mteter-upenn/PCB_PiGateway/board_design_map.txt

1.x: Pololu PS, DIP switches, full size, male term blocks
2.x: Recom PS, DIP switches, full size, male and female term blocks
3.x: Recom PS, DIP switches, reduc size, term block and barrel jack
