mteter-upenn/PCB_PiGateway/Modbus_shield_purchase_list.xlsx

Sheet: teensy
 |  | Approx. |  | Approx. | Req for 4.0
Part | Link | Cost Per | # to Order | Order Cost |  | New | Total # Desired | # in Stock | # Being Shipped | Alternatives
PCB - 3V3 - 42 x 49 mm | OSHPark (https://oshpark.com/) | $5.32 | 0 | $0.00 | 0 | 0 | 0 | 0 | 0
PCB -3V3 - 32.8 x 86.9 mm | OSHPark (https://oshpark.com/) | $7.35 | 0 | $0.00 | 0 | 0 | 0 | 0 | 0
PCB - 3V3 - 49.5 x 58.5 mm | OSHPark (https://oshpark.com/) | $7.47 | 3 | $22.42 | 3 | 3 | 3 | 0 | 0
Teensy 3.2 | PJRC (https://www.pjrc.com/store/teensy32.html) | $19.80 | 3 | $59.40 | 3 | 3 | 3 | 0 | 0 | SparkFun (https://www.sparkfun.com/products/13736) | $19.95
Teensy SD Card Adapter | PJRC (https://www.pjrc.com/store/wiz820_sd_adaptor.html) | $6.00 | 3 | $18.00 | 3 | 3 | 3 | 0 | 0
Wiz820io | Mouser (http://www.mouser.com/ProductDetail/WIZnet/WIZ820io/?qs=b%252bXOOdUOuvZr7ySTpTRyJw%3D%3D) | $20.79 | 3 | $62.37 | 3 | 3 | 3 | 0 | 0
32.768 kHz Crystal 5ppm | Digikey (http://www.digikey.com/product-search/en?keywords=300-8763-ND) | $0.60 | 3 | $1.80 | 3 | 3 | 3 | 0 | 0
CR2032 Battery | Digikey (http://www.digikey.com/product-detail/en/CR2032/P189-ND/31939) | $0.28 | 3 | $0.84 | 3 | 3 | 3 | 0 | 0
Vert CR2032 Battery Holder | Digikey (http://www.digikey.com/product-detail/en/BK-5058/BK-5058-ND/2194769) | $0.88 | 3 | $2.64 | 3 | 3 | 3 | 0 | 0
1x4 female header | Digikey (http://www.digikey.com/product-detail/en/PPPC041LFBN-RC/S7037-ND/810176) | $0.62 | 0 | $0.00 | 0 | 0 | 6 | 6 | 0
1x5 female header | Digikey (http://www.digikey.com/product-detail/en/PPPC051LFBN-RC/S7038-ND/810177) | $0.65 | 3 | $1.95 | 3 | 3 | 3 | 0 | 0
1x6 female header | Digikey (http://www.digikey.com/product-detail/en/PPPC061LFBN-RC/S7039-ND/810178) | $0.70 | 6 | $4.20 | 6 | 6 | 6 | 0 | 0
1x14 female header | Digikey (http://www.digikey.com/product-detail/en/PPPC141LFBN-RC/S7047-ND/810186) | $0.98 | 12 | $11.76 | 12 | 12 | 12 | 0 | 0
1x40 male header | Digikey (http://www.digikey.com/product-detail/en/PRPC040SAAN-RC/S1011EC-40-ND/2775214) | $0.74 | 0 | $0.00 | 1 | 0 | 21.875 | 21.875 | 0
1x40 male dbl long header | Digikey (http://www.digikey.com/product-search/en?vendor=0&keywords=PRPC040SACN-RC) | $0.99 | 1 | $0.99 | 3 | 1 | 3.175 | 2.175 | 0 |  | 64
120ohm 1206 resistor | Digikey (http://www.digikey.com/product-detail/en/RC1206FR-07120RL/311-120FRCT-ND/731470) | $0.10 | 0 | $0.00 | 0 | 0 | 0 | 0 | 0
270ohm 1206 resistor | Digikey (http://www.digikey.com/product-detail/en/RC1206FR-07270RL/311-270FRCT-ND/731681) | $0.10 | 0 | $0.00 | 0 | 0 | 0 | 0 | 0 | 10
510ohm 1206 resistor | Digikey (http://www.digikey.com/product-detail/en/RC1206JR-07510RL/311-510ERCT-ND/732257) | $0.10 | 0 | $0.00 | 0 | 0 | 0 | 0 | 0 | 10
680ohm 1206 resistor | Digikey (http://www.digikey.com/product-detail/en/RC1206FR-07680RL/311-680FRCT-ND/732011) | $0.10 | 0 | $0.00 | 0 | 0 | 0 | 0 | 0 | 10
1kohm 1206 resistor | Digikey (http://www.digikey.com/product-detail/en/RC1206FR-071KL/311-1.00KFRCT-ND/731334) | $0.10 | 0 | $0.00 | 0 | 0 | 0 | 0 | 0 | 10
10kohm 1206 resistor | Digikey (http://www.digikey.com/product-detail/en/RC1206JR-0710KL/311-10KERCT-ND/732156) | $0.10 | 0 | $0.00 | 0 | 0 | 0 | 0 | 0 | 10
104 1206 capacitor | Digikey (http://www.digikey.com/product-detail/en/C1206C104J5RACTU/399-1250-1-ND/411525) | $0.10 | 0 | $0.00 | 0 | 0 | 0 | 0 | 0
Green 2V 20mA 1206 LED | Digikey (http://www.digikey.com/product-detail/en/LTST-C230KGKT/160-1456-1-ND/386854) | $0.30 | 0 | $0.00 | 0 | 0 | 0 | 0 | 0
Red 2V 20mA 1206 LED | Digikey (http://www.digikey.com/product-detail/en/LTST-C230KRKT/160-1457-1-ND/386856) | $0.30 | 0 | $0.00 | 0 | 0 | 0 | 0 | 0
Orange 2V 20mA 1206 LED | Digikey (http://www.digikey.com/product-detail/en/LTST-C230KFKT/160-2025-1-ND/3711400) | $0.29 | 0 | $0.00 | 0 | 0 | 0 | 0 | 0
120ohm 0603 resistor | Digikey (http://www.digikey.com/product-detail/en/RC0603FR-07120RL/311-120HRCT-ND/729867) | $0.01 | 10 | $0.14 | 3 | 10 | 11 | 1 | 0
180ohm 0603 resistor | Digikey (http://www.digikey.com/product-detail/en/yageo/RC0603FR-07180RL/311-180HRCT-ND/729941) | $0.01 | 10 | $0.14 | 3 | 10 | 10 | 0 | 0
270ohm 0603 resistor | Digikey (http://www.digikey.com/product-detail/en/RC0603FR-07270RL/311-270HRCT-ND/730050) | $0.01 | 10 | $0.14 | 3 | 10 | 11 | 1 | 0
510ohm 0603 resistor | Digikey (http://www.digikey.com/product-detail/en/RC0603FR-07510RL/311-510HRCT-ND/730232) | $0.01 | 10 | $0.14 | 6 | 10 | 10 | 0 | 0
680ohm 0603 resistor | Digikey (http://www.digikey.com/product-detail/en/RC0603FR-07680RL/311-680HRCT-ND/730302) | $0.01 | 15 | $0.15 | 15 | 15 | 20 | 5 | 0
1kohm 0603 resistor | Digikey (http://www.digikey.com/product-detail/en/RC0603FR-071KL/311-1.00KHRCT-ND/729790) | $0.01 | 10 | $0.14 | 12 | 10 | 18 | 8 | 0
5.1kohm 0603 resistor | Digikey (http://www.digikey.com/product-detail/en/yageo/RC0603FR-075K1L/311-5.10KHRCT-ND/730215) | $0.01 | 10 | $0.14 | 3 | 10 | 10 | 0 | 0
10kohm 0603 resistor | Digikey (http://www.digikey.com/product-detail/en/RC0603FR-0710KL/311-10.0KHRCT-ND/729827) | $0.01 | 10 | $0.14 | 6 | 10 | 12 | 2 | 0
33kohm 0603 resistor | Digikey (http://www.digikey.com/product-detail/en/RC0603FR-0733KL/311-33.0KHRCT-ND/730106) | $0.01 | 10 | $0.10 | 3 | 10 | 11 | 1 | 0
104 0603 capacitor | Digikey (http://www.digikey.com/product-detail/en/C0603C104J4RACTU/399-1097-1-ND/411372) | $0.11 | 6 | $0.66 | 6 | 6 | 6 | 0 | 0
273 0603 capacitor | Digikey (http://www.digikey.com/product-detail/en/samsung-electro-mechanics-america-inc/CL10B273KB8NNNC/1276-2025-1-ND/3890111) | $0.11 | 3 | $0.33 | 3 | 3 | 3 | 0 | 0
Green 2V 20mA 0603 LED | Digikey (http://www.digikey.com/product-detail/en/LTST-C191KGKT/160-1446-1-ND/386834) | $0.29 | 3 | $0.87 | 3 | 3 | 3 | 0 | 0
Red 2V 20mA 0603 LED | Digikey (http://www.digikey.com/product-detail/en/LTST-C191KRKT/160-1447-1-ND/386836) | $0.29 | 10 | $2.90 | 9 | 10 | 17 | 7 | 0
Yellow 2V 20mA 0603 LED | Digikey (http://www.digikey.com/product-detail/en/lite-on-inc/LTST-C191KSKT/160-1448-1-ND/386838) | $0.30 | 12 | $3.60 | 12 | 12 | 13 | 1 | 0
Term Block 6Pin .2" 180 header | Digikey (http://www.digikey.com/product-detail/en/1546111-6/A112348-ND/2221132) | $2.42 | 0 | $0.00 | 0 | 0 | 0 | 0 | 0
Term Block 3 Pin .2" 90 header | Digikey (http://www.digikey.com/product-detail/en/796639-3/A114504-ND/1131834) | $0.86 | 6 | $5.16 | 6 | 6 | 6 | 0 | 0
Term Block 3 Pin .2" 270 Plug | Digikey (http://www.digikey.com/product-detail/en/284041-3/A98129-ND/1826991) | $2.73 | 6 | $16.38 | 6 | 6 | 6 | 0 | 0
R-78-E5.0, 500mA voltage regulator | Digikey (http://www.digikey.com/product-detail/en/recom-power/R-78E5.0-0.5/945-1648-5-ND/2834904) | $2.84 | 3 | $8.52 | 3 | 3 | 3 | 0 | 0
Wide DIN case | Digikey (http://www.digikey.com/product-detail/en/DMB-4771/377-1808-ND/2499327) | $5.50 | 3 | $16.50 | 3 | 3 | 3 | 0 | 0
Wide DIN case clear cover | Digikey (http://www.digikey.com/product-search/en?vendor=0&keywords=dmb-4771-cc) | $1.10 | 3 | $3.30 | 3 | 3 | 3 | 0 | 0
Slim DIN case | Digikey (http://www.digikey.com/product-detail/en/DMB-4770/377-1807-ND/2499326) | $4.50 | 0 | $0.00 | 0 | 0 | 0 | 0 | 0
Heatsink 10mm square | Digikey (http://www.digikey.com/product-detail/en/assmann-wsw-components/V2017B/AE10837-ND/3511410) | $0.75 | 6 | $4.50 | 3 | 6 | 6 | 0 | 0
16GB Micro SD Card | Amazon (https://www.amazon.com/SanDisk-Ultra-Micro-Adapter-SDSQUNC-016G-GN6MA/dp/B010Q57SEE) | $9.70 | 3 | $29.10 | 3 | 3 | 3 | 0 | 0
Max485esa+ transceiver | Digikey (http://www.digikey.com/product-detail/en/MAX485ESA%2B/MAX485ESA%2B-ND/1495323) | $2.66 | 3 | $7.98 | 3 | 3 | 3 | 0 | 0
2N7002 transistor sot-23-3 | Digikey (http://www.digikey.com/product-detail/en/2N7002LT1G/2N7002LT1GOSCT-ND/917791) | $0.14 | 10 | $1.40 | 9 | 10 | 19 | 9 | 0
NC7SB3157P6X SPDT | Digikey (http://www.digikey.com/product-detail/en/fairchild-semiconductor/NC7SB3157P6X/NC7SB3157P6XCT-ND/1305384) | $0.39 | 3 | $1.17 | 3 | 3 | 3 | 0 | 0
FSA3357K8X SP3T | Digikey (http://www.digikey.com/product-detail/en/fairchild-semiconductor/FSA3357K8X/FSA3357K8XCT-ND/821001) | $0.96 | 3 | $2.88 | 3 | 3 | 3 | 0 | 0
MAX4525EUB+ DPDT | Digikey (http://www.digikey.com/product-detail/en/maxim-integrated/MAX4525EUB-/MAX4525EUB--ND/1780258) | $2.56 | 3 | $7.68 | 3 | 3 | 3 | 0 | 0
MB85RS256BPNF FRAM 32kB Memory | Digikey (http://www.digikey.com/product-detail/en/fujitsu-electronics-america-inc/MB85RS256BPNF-G-JNERE1/865-1251-1-ND/4022686) | $3.50 | 3 | $10.50 | 3 | 3 | 3 | 0 | 0
SPDT dip switch | Digikey (http://www.digikey.com/product-detail/en/CJS-1200TB/563-1022-1-ND/948402) | $0.86 | 0 | $0.00 | 0 | 0 | 0 | 0 | 0
SPDT dip switch neutral setting | Digikey (http://www.digikey.com/product-detail/en/CJS-1201TB/563-1024-1-ND/948406) | $1.11 | 0 | $0.00 | 0 | 0 | 0 | 0 | 0
DPDT dip switch | Digikey (http://www.digikey.com/product-detail/en/CAS-220TB/CAS220GCT-ND/341727) | $2.04 | 0 | $0.00 | 0 | 0 | 0 | 0 | 0
One offs:
Display Board | Amazon (http://www.amazon.com/dp/B019K6CRVY/ref=sxr_pa_click_within_right_aps_sr_pg1_2?psc=1) | $72.90 | 0 | $0.00 |  | 0 | 0 | 0 | 0
Raspberry Pi 2 | Amazon (http://www.amazon.com/Raspberry-Pi-Model-Project-Board/dp/B00T2U7R7I?s=pc) | $36.05 | 0 | $0.00 |  | 0 | 0 | 0 | 0
5V 2.5 A Power Supply | Amazon (http://www.amazon.com/CanaKit-Raspberry-Supply-Adapter-Charger/dp/B00MARDJZ4) | $9.99 | 0 | $0.00 |  | 0 | 0 | 0 | 0
Anti Static Mat | Amazon (https://smile.amazon.com/StarTech-com-24x27-5-Inch-Desktop-Anti-Static-M3013/dp/B00009XT3H) | $15.83 | 1 | $15.83 |  | 1 | 1 | 0 | 0
Anti Static Wrist Band | Amazon (https://smile.amazon.com/Rosewill-Anti-Static-Components-RTK-002-Yellow/dp/B004N8ZQKY) | $5.99 | 1 | $5.99 |  | 1 | 1 | 0 | 0
Plug with Ground | Amazon (https://smile.amazon.com/Leviton-5266-C-Industrial-Grounding-Black-White/dp/B001VXU4TC) | $7.49 | 1 | $7.49 |  | 1 | 1 | 0 | 0
No Clean Flux | Amazon (https://www.amazon.com/gp/product/B00425FUW2?ref%5F=sr%5F1%5F4&pldnSite=1) | $12.29 | 1 | $12.29 |  | 1 | 1 | 0 | 0
Soldering Paste | Amazon (https://smile.amazon.com/Clean-Leaded-Solder-Paste-Grams/dp/B017RSZFQQ) | $9.95 | 1 | $9.95 |  | 1 | 1 | 0 | 0
Kim dry wipes | Amazon (https://www.amazon.com/gp/product/B00RORBXA8?ref%5F=sr%5F1%5F1&pldnSite=1) | $5.30 | 1 | $5.30 |  | 1 | 1 | 0 | 0
Tweezers | Sparkfun (https://www.sparkfun.com/products/10602) | $3.95 | 0 | $0.00 |  | 0 | 0 | 0 | 0
USB A to micro | Amazon (http://www.amazon.com/dp/B00NH13LSM/ref=twister_B00DGRUY3M?_encoding=UTF8&psc=1) | $4.69 | 0 | $0.00 |  | 0 | 0 | 0 | 0
USB A to Micro | Adafruit (https://www.adafruit.com/products/592) | $2.95 | 0 | $0.00 |  | 0 | 0 | 0 | 0
USB A to micro | Digikey (http://www.digikey.com/product-detail/en/3025010-03/Q853-ND/4341883) | $2.31 | 0 | $0.00 |  | 0 | 0 | 0 | 0
9V 650mA Power Supply | Sparkfun (https://www.sparkfun.com/products/298) | $5.95 | 0 | $0.00 |  | 0 | 0 | 0 | 0
5V 2A (2000mA) switching power supply | Adafruit (https://www.adafruit.com/products/276) | $7.95 | 0 | $0.00 |  | 0 | 0 | 0 | 0
5V 2A Switching Power Supply w/ USB-A Connector | Adafruit (https://www.adafruit.com/products/1994) | $6.95 | 0 | $0.00 |  | 0 | 0 | 0 | 0
5V 550mA Switch PS via USB | Digikey (http://www.digikey.com/product-detail/en/PSM03A-050Q/993-1030-ND/2384456) | $4.25 | 0 | $0.00 |  | 0 | 0 | 0 | 0
Bluetooth Mouse | Amazon (https://www.amazon.com/Microsoft-Sculpt-Comfort-Bluetooth-H3S-00003/dp/B00BZC31WQ?s=pc) | $24.95 | 0 | $0.00 |  | 0 | 0 | 0 | 0
Electric Soldering Iron | Amazon (http://smile.amazon.com/Weller-WES51-Analog-Soldering-Station/dp/B000BRC2XU) | $93.37 | 0 | $0.00 |  | 0 | 0 | 0 | 0
Small soldering tip | Amazon (http://smile.amazon.com/Weller-eto-0-8-PRICE-EACH/dp/B0002BSQRQ) | $6.11 | 0 | $0.00 |  | 0 | 0 | 0 | 0
Small soldering tip | Digikey (http://www.digikey.com/product-detail/en/ETH/ETH-ND/251751) | $4.10 | 0 | $0.00 |  | 0 | 0 | 0 | 0
Head magnifier | Amazon (http://smile.amazon.com/gp/product/B003UCODIA?psc=1&redirect=true&ref_=oh_aui_search_detailpage) | $8.99 | 0 | $0.00 |  | 0 | 0 | 0 | 0
AAA Batteries | Digikey (http://www.digikey.com/product-detail/en/LR03XWA%2FB/P645-ND/2043736) | $0.38 | 0 | $0.00 |  | 0 | 0 | 0 | 0
pcb vise | Amazon (http://smile.amazon.com/gp/product/B000B61D22?psc=1&redirect=true&ref_=oh_aui_search_detailpage) | $26.99 | 0 | $0.00 |  | 0 | 0 | 0 | 0
Total |  |  |  | $367.88
 |  |  |  |  |  |  |  | $25.88
 |  |  |  |  | $103.51 | board cost
Discontinued
Orange 2V 20mA 0603 LED | Digikey (http://www.digikey.com/product-detail/en/LTST-C191KFKT/160-1445-1-ND/386832) | $0.24 | 0 | $0.00 | 0 | 0 | 0 | 0 | 0
MCP1825S33 3V3 Voltage Regulator | Digikey (http://www.digikey.com/product-detail/en/MCP1825S-3302E%2FDB/MCP1825S-3302E%2FDB-ND/1636103) | $0.51 | 0 | $0.00 | 0 | 0 | 0 | 0 | 0
485 shield | Sparkfun (https://www.sparkfun.com/products/12965) | $11.95 | 0 | $0.00 | 0 | 0 | 0 | 0 | 0
2.1mm barrel jack | Pololu (https://www.pololu.com/product/1139) | $0.85 | 0 | $0.00 | 0 | 0 | 2 | 2 | 0
D24V5F5 5V, .5A power regulator | Pololu (https://www.pololu.com/product/2843) | $4.95 | 0 | $0.00 | 0 | 0 | 2 | 2 | 0
CR2032 Battery Holder | Sparkfun (https://www.sparkfun.com/products/783) | $1.50 | 0 | $0.00 | 0 | 0 | 0 | 0 | 0
Heat sink .4 x .4" | Adafruit (https://www.adafruit.com/products/1042) | $1.95 | 0 | $0.00 | 0 | 0 | 3 | 3 | 0
Heat Sink .25 x .25" | Adafruit (https://www.adafruit.com/products/1515) | $4.95 | 0 | $0.00 | 0 | 0 | 0 | 0 | 0
8GB Micro SD Card | Amazon (http://www.amazon.com/SanDisk-MicroSDHC-Standard-Packaging-SDSDQUAN-008G-G4A/dp/B00M55C0VU) | $7.62 | 0 | $0.00 | 0 | 0 | 0 | 0 | 0
32GB Micro SD Card | Amazon (http://www.amazon.com/SanDisk-microSDHC-Standard-Packaging-SDSQUNC-032G-GN6MA/dp/B010Q57T02?s=electronics) | $12.86 | 0 | $0.00 | 0 | 0 | 0 | 0 | 0
D24V5F3, .5A power regulator | Pololu (https://www.pololu.com/product/2842) | $4.95 | 0 | $0.00 | 0 | 0 | 0 | 0 | 0
1x8 female header | Digikey (http://www.digikey.com/product-detail/en/PPPC081LFBN-RC/S7041-ND/810180) | $0.89 | 0 | $0.00 | 0 | 0 | 0 | 0 | 0
100ohm 1206 resistor | Digikey (http://www.digikey.com/product-detail/en/RC1206FR-07100RL/311-100FRCT-ND/731438) | $0.10 | 0 | $0.00 | 0 | 0 | 0 | 0 | 0
220ohm 1206 resistor | Digikey (http://www.digikey.com/product-detail/en/RC1206FR-07220RL/311-220FRCT-ND/731640) | $0.10 | 0 | $0.00 | 0 | 0 | 0 | 0 | 0
Term Block 3 Pin .2" 180 plug | Digikey (http://www.digikey.com/product-detail/en/796634-3/A98224-ND/1827083) | $1.40 | 0 | $0.00 | 0 | 0 | 0 | 0 | 0
 |  |  |  |  |  |  | 1.5
 |  |  |  | 29.4 |  |  | 0.002205882353
 |  |  |  | 8.4 |  |  | 1450.666667
 |  |  |  | 26.22
 |  |  |  | 3.18 |  |  | 0.0032
 |  |  |  | 3.35

Sheet: pi
 |  | Approx. | 6 | Approx. | Req for 1.0 |  | 2.0
Part | Link | Cost Per | # to Order | Order Cost | per brd | total |  |  | New | Total # Desired | # in Stock | # Being Shipped | Alternatives
485/Power PiHat 1.0 | OSHPark (https://oshpark.com/) | $9.40 | 0 | $0.00 | 1 | 6 | 0 | 0 | 0 | 0 | 0 | 0
485/Power PiHat 2.0 | OSHPark (https://oshpark.com/) | $9.40 | 0 | $0.00 | 0 | 0 | 0 | 0 | 0 | 0 | 0 | 0
485/Power PiHat 2.0 Super Swift | OSHPark (https://oshpark.com/) | $18.80 | 0 | $0.00 | 0 | 0 | 1 | 6 | 0 | 0 | 0 | 0
Raspberry Pi 3 Model B | Amazon (https://www.amazon.com/Raspberry-Model-1-2GHz-64-bit-quad-core/dp/B01CD5VC92?s=pc) | $36.99 | 0 | $0.00 | 1 | 6 | 1 | 6 | 0 | 0 | 0 | 0
#4-40 3/16" screw (100 pk) | McMaster-Carr (https://www.mcmaster.com/) | $1.62 | 0 | $0.00 | 0.04 | 1 | 0.04 | 1 | 0 | 0.61 | 0.61 | 0
#4-40 nut (100 pk) | McMaster-Carr (https://www.mcmaster.com/) | $2.36 | 0 | $0.00 | 0.02 | 1 | 0.02 | 1 | 0 | 0.82 | 0.82 | 0
#4-40 7/16" standoff | McMaster-Carr (https://www.mcmaster.com/) | $0.68 | 0 | $0.00 | 4 | 24 | 4 | 24 | 0 | 0 | 0 | 0
M2.5x.45 12mm standoffs | Digikey (https://www.digikey.com/products/en/hardware-fasteners-accessories/board-spacers-standoffs/582?k=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) | $0.53 | 0 | $0.00 | 0 | 0 | 0 | 0 | 0 | 0 | 0 | 0
M2.5x.45 6mm screws | Digikey (https://www.digikey.com/product-detail/en/keystone-electronics/29301/36-29301-ND/1532984) | $0.38 | 0 | $0.00 | 0 | 0 | 0 | 0 | 0 | 0 | 0 | 0
50pc M2.5x.45 6mm screws | Amazon (https://www.amazon.com/uxcell-M2-5x6mm-Stainless-Phillips-Machine/dp/B01LK6XXCE) | $7.33 | 0 | $0.00 | 0 | 0 | 0 | 0 | 0 | 0 | 0 | 0
100pc M2.5x.45 8mm countersunk | Amazon (https://www.amazon.com/Phillips-Countersunk-Machine-Stainless-100-piece/dp/B06XCBL7Q6) | $4.69 | 0 | $0.00 | 0 | 0 | 0 | 0 | 0 | 0 | 0 | 0
M2.5x.45 nut | Digikey (https://www.digikey.com/product-detail/en/keystone-electronics/4707/36-4707-ND/4499300) | $0.14 | 0 | $0.00 | 0 | 0 | 0 | 0 | 0 | 0 | 0 | 0
DIN Rail enclosure | Allied Electronics (https://www.alliedelec.com/hitaltech-usa-25-041all01-rmb/70420316/) | $14.62 | 0 | $0.00 | 1 | 6 | 1 | 6 | 0 | 0 | 0 | 0
Trans 2PNP BCM857BS | Digikey (https://www.digikey.com/product-detail/en/nexperia-usa-inc/BCM857BS115/1727-4883-1-ND/2531387) | $0.41 | 0 | $0.00 | 1 | 6 | 1 | 6 | 0 | 1 | 1 | 0
Mosfet P-ch DMG2305UX-13 | Digikey (https://www.digikey.com/product-detail/en/diodes-incorporated/DMG2305UX-13/DMG2305UX-13DICT-ND/4251589) | $0.42 | 0 | $0.00 | 1 | 6 | 1 | 6 | 0 | 1 | 1 | 0
Fuse MF-MSMF250 | Digikey (https://www.digikey.com/product-detail/en/bourns-inc/MF-MSMF250-16X-2/MF-MSMF250-16X-2CT-ND/3437789) | $0.81 | 0 | $0.00 | 1 | 6 | 1 | 6 | 0 | 1 | 1 | 0
Diode SMBJ5.0A | Digikey (https://www.digikey.com/product-detail/en/littelfuse-inc/SMBJ5.0A/SMBJ5.0ALFCT-ND/285951) | $0.42 | 0 | $0.00 | 1 | 6 | 1 | 6 | 0 | 1 | 1 | 0
5V 2.5A Buck Converter | Pololu (https://www.pololu.com/product/2858) | $8.95 | 0 | $0.00 | 1 | 6 | 0 | 0 | 0 | 0 | 0 | 0
TI 5V 1.5A DC DC Converter | Digikey (https://www.digikey.com/product-detail/en/texas-instruments/TPSM84205EAB/296-47074-ND/7561620) | $6.28 | 0 | $0.00 | 0 | 0 | 0 | 0 | 0 | 0 | 0 | 0
R-78E5.0-1.0 5V 1A DC DC Converter | Digikey (https://www.digikey.com/product-detail/en/recom-power/R-78E5.0-1.0/945-2201-ND/4930585) | $3.26 | 0 | $0.00 | 0 | 0 | 1 | 6 | 0 | 0 | 0 | 0
120ohm 1% 0603 resistor | Digikey (http://www.digikey.com/product-detail/en/RC0603FR-07120RL/311-120HRCT-ND/729867) | $0.01 | 0 | $0.00 | 1 | 6 | 1 | 6 | 0 | 11 | 11 | 0
180ohm 1% 0603 resistor | Digikey (http://www.digikey.com/product-detail/en/yageo/RC0603FR-07180RL/311-180HRCT-ND/729941) | $0.01 | 0 | $0.00 | 1 | 6 | 1 | 6 | 0 | 9 | 9 | 0
270ohm 1% 0603 resistor | Digikey (http://www.digikey.com/product-detail/en/RC0603FR-07270RL/311-270HRCT-ND/730050) | $0.01 | 0 | $0.00 | 0 | 0 | 0 | 0 | 0 | 10 | 10 | 0
510ohm 1% 0603 resistor | Digikey (http://www.digikey.com/product-detail/en/RC0603FR-07510RL/311-510HRCT-ND/730232) | $0.01 | 0 | $0.00 | 3 | 18 | 3 | 18 | 0 | 4 | 4 | 0
680ohm 1% 0603 resistor | Digikey (http://www.digikey.com/product-detail/en/RC0603FR-07680RL/311-680HRCT-ND/730302) | $0.01 | 0 | $0.00 | 0 | 0 | 0 | 0 | 0 | 22 | 22 | 0
1kohm 1% 0603 resistor | Digikey (http://www.digikey.com/product-detail/en/RC0603FR-071KL/311-1.00KHRCT-ND/729790) | $0.01 | 0 | $0.00 | 3 | 18 | 3 | 18 | 0 | 6 | 6 | 0
10kohm 1% 0603 resistor | Digikey (http://www.digikey.com/product-detail/en/RC0603FR-0710KL/311-10.0KHRCT-ND/729827) | $0.01 | 0 | $0.00 | 3 | 18 | 3 | 18 | 0 | 3 | 3 | 0
33kohm 1% 0603 resistor | Digikey (http://www.digikey.com/product-detail/en/RC0603FR-0733KL/311-33.0KHRCT-ND/730106) | $0.01 | 0 | $0.00 | 1 | 6 | 1 | 6 | 0 | 10 | 10 | 0
47kohm 1% 0603 resistor | Digikey (https://www.digikey.com/product-detail/en/yageo/RC0603FR-0747KL/311-47.0KHRCT-ND/730200) | $0.01 | 0 | $0.00 | 1 | 6 | 1 | 6 | 0 | 1 | 1 | 0
104 100 nF 0603 capacitor | Digikey (http://www.digikey.com/product-detail/en/C0603C104J4RACTU/399-1097-1-ND/411372) | $0.12 | 0 | $0.00 | 1 | 6 | 1 | 6 | 0 | 7 | 7 | 0
105 1uF 0603 capacitor | Digikey (https://www.digikey.com/product-detail/en/samsung-electro-mechanics-america-inc/CL10B105KP8NNNC/1276-1946-1-ND/3890032) | $0.10 | 0 | $0.00 | 1 | 6 | 1 | 6 | 0 | 1 | 1 | 0
476 47 uF 0603 capacitor | Digikey (https://www.digikey.com/product-detail/en/murata-electronics-north-america/GRM188C80E476ME05D/490-13244-1-ND/5877452) | $0.52 | 0 | $0.00 | 1 | 6 | 1 | 6 | 0 | 2 | 2 | 0
Green 2V 20mA 0603 LED | Digikey (http://www.digikey.com/product-detail/en/LTST-C191KGKT/160-1446-1-ND/386834) | $0.29 | 0 | $0.00 | 1 | 6 | 1 | 6 | 0 | 3 | 3 | 0
Red 2V 20mA 0603 LED | Digikey (http://www.digikey.com/product-detail/en/LTST-C191KRKT/160-1447-1-ND/386836) | $0.29 | 0 | $0.00 | 1 | 6 | 1 | 6 | 0 | 15 | 15 | 0
Yellow 2V 20mA 0603 LED | Digikey (https://www.digikey.com/product-detail/en/lite-on-inc/LTST-C190YKT/160-1184-1-ND/269256) | $0.29 | 0 | $0.00 | 2 | 12 | 2 | 12 | 0 | 6 | 6 | 0
Barrel Jack 2.1mm | Digikey (https://www.digikey.com/product-detail/en/cui-inc/PJ-002A/CP-002A-ND/96962) | $0.60 | 0 | $0.00 | 0 | 0 | 0 | 0 | 0 | 0 | 0 | 0
Barrel Plug 2.1 mm | Digikey (https://www.digikey.com/product-detail/en/mpd-memory-protection-devices/EP502A/EP502A-ND/2439554) | $1.02 | 0 | $0.00 | 0 | 0 | 0 | 0 | 0 | 0 | 0 | 0
2x20 female header | Digikey (https://www.digikey.com/product-detail/en/sullins-connector-solutions/PPTC202LFBN-RC/S6104-ND/807240) | $2.29 | 0 | $0.00 | 1 | 6 | 1 | 6 | 0 | 0 | 0 | 0
Term Block 3 Pin .2" 90 male header | Digikey (http://www.digikey.com/product-detail/en/796639-3/A114504-ND/1131834) | $1.03 | 0 | $0.00 | 2 | 12 | 1 | 6 | 0 | 2 | 2 | 0
Term Block 3 Pin .2" 180 female plug | Digikey (https://www.digikey.com/product-detail/en/te-connectivity-amp-connectors/796635-3/796635-3-ND/2223482) | $2.77 | 0 | $0.00 | 2 | 12 | 1 | 6 | 0 | 6 | 6 | 0
Term Block 3 Pin .2" 90 female header | Digikey (https://www.digikey.com/product-detail/en/phoenix-contact/1786417/277-5985-ND/349072) | $3.08 | 0 | $0.00 | 0 | 0 | 1 | 6 | 0 | 4 | 4 | 0
Term Block 3 Pin .2" 180 male plug | Digikey (https://www.digikey.com/product-detail/en/phoenix-contact/1786187/277-5720-ND/349067) | $4.28 | 0 | $0.00 | 0 | 0 | 1 | 6 | 0 | 3 | 3 | 0
16GB Micro SD Card | Amazon (https://www.amazon.com/SanDisk-Ultra-Micro-Adapter-SDSQUNC-016G-GN6MA/dp/B010Q57SEE) | $9.99 | 0 | $0.00 | 1 | 6 | 1 | 6 | 0 | 7 | 7 | 0
MAX3485CSA Transceiver 3V | Digikey (https://www.digikey.com/product-detail/en/maxim-integrated/MAX3485CSA-T/MAX3485CSA-CT-ND/5405739) | $4.57 | 0 | $0.00 | 1 | 6 | 1 | 6 | 0 | 1 | 1 | 0
2N7002 transistor sot-23-3 | Digikey (https://www.digikey.com/product-detail/en/diodes-incorporated/2N7002K-7/2N7002K-7DICT-ND/3053305) | $0.22 | 100 | $22.00 | 3 | 18 | 3 | 18 | 100 | 100 | 0 | 0
FSA3357K8X SP3T | Digikey (http://www.digikey.com/product-detail/en/fairchild-semiconductor/FSA3357K8X/FSA3357K8XCT-ND/821001) | $0.97 | 0 | $0.00 | 0 | 0 | 0 | 0 | 0 | 0 | 0 | 0
MAX4525EUB+ DPDT | Digikey (http://www.digikey.com/product-detail/en/maxim-integrated/MAX4525EUB-/MAX4525EUB--ND/1780258) | $2.56 | 0 | $0.00 | 0 | 0 | 0 | 0 | 0 | 0 | 0 | 0
SPDT dip switch neutral setting | Digikey (http://www.digikey.com/product-detail/en/CJS-1201TB/563-1024-1-ND/948406) | $1.11 | 0 | $0.00 | 1 | 6 | 1 | 6 | 0 | 5 | 5 | 0
DPDT dip switch | Digikey (http://www.digikey.com/product-detail/en/CAS-220TB/CAS220GCT-ND/341727) | $1.96 | 0 | $0.00 | 1 | 6 | 1 | 6 | 0 | 5 | 5 | 0
 |  |  |  |  |  |  |  |  |  |  | .
One offs:
Display Board | Amazon (http://www.amazon.com/dp/B019K6CRVY/ref=sxr_pa_click_within_right_aps_sr_pg1_2?psc=1) | $72.90 | 0 | $0.00 |  |  |  |  | 0 | 0 | 0 | 0
Raspberry Pi 2 | Amazon (http://www.amazon.com/Raspberry-Pi-Model-Project-Board/dp/B00T2U7R7I?s=pc) | $36.05 | 0 | $0.00 |  |  |  |  | 0 | 0 | 0 | 0
5V 2.5 A Power Supply | Amazon (http://www.amazon.com/CanaKit-Raspberry-Supply-Adapter-Charger/dp/B00MARDJZ4) | $9.99 | 0 | $0.00 |  |  |  |  | 0 | 0 | 0 | 0
Anti Static Mat | Amazon (https://smile.amazon.com/StarTech-com-24x27-5-Inch-Desktop-Anti-Static-M3013/dp/B00009XT3H) | $15.83 | 0 | $0.00 |  |  |  |  | 1 | 1 | 0 | 0
Anti Static Wrist Band | Amazon (https://smile.amazon.com/Rosewill-Anti-Static-Components-RTK-002-Yellow/dp/B004N8ZQKY) | $5.99 | 0 | $0.00 |  |  |  |  | 1 | 1 | 0 | 0
Plug with Ground | Amazon (https://smile.amazon.com/Leviton-5266-C-Industrial-Grounding-Black-White/dp/B001VXU4TC) | $7.49 | 0 | $0.00 |  |  |  |  | 1 | 1 | 0 | 0
No Clean Flux | Amazon (https://www.amazon.com/gp/product/B00425FUW2?ref%5F=sr%5F1%5F4&pldnSite=1) | $12.29 | 0 | $0.00 |  |  |  |  | 1 | 1 | 0 | 0
Soldering Paste | Amazon (https://smile.amazon.com/Clean-Leaded-Solder-Paste-Grams/dp/B017RSZFQQ) | $9.95 | 0 | $0.00 |  |  |  |  | 1 | 1 | 0 | 0
Kim dry wipes | Amazon (https://www.amazon.com/gp/product/B00RORBXA8?ref%5F=sr%5F1%5F1&pldnSite=1) | $5.30 | 0 | $0.00 |  |  |  |  | 1 | 1 | 0 | 0
Tweezers | Sparkfun (https://www.sparkfun.com/products/10602) | $3.95 | 0 | $0.00 |  |  |  |  | 0 | 0 | 0 | 0
USB A to micro | Amazon (http://www.amazon.com/dp/B00NH13LSM/ref=twister_B00DGRUY3M?_encoding=UTF8&psc=1) | $4.69 | 0 | $0.00 |  |  |  |  | 0 | 0 | 0 | 0
USB A to Micro | Adafruit (https://www.adafruit.com/products/592) | $2.95 | 0 | $0.00 |  |  |  |  | 0 | 0 | 0 | 0
USB A to micro | Digikey (http://www.digikey.com/product-detail/en/3025010-03/Q853-ND/4341883) | $2.31 | 0 | $0.00 |  |  |  |  | 0 | 0 | 0 | 0
9V 650mA Power Supply | Sparkfun (https://www.sparkfun.com/products/298) | $5.95 | 0 | $0.00 |  |  |  |  | 0 | 0 | 0 | 0
5V 2A (2000mA) switching power supply | Adafruit (https://www.adafruit.com/products/276) | $7.95 | 0 | $0.00 |  |  |  |  | 0 | 0 | 0 | 0
5V 2A Switching Power Supply w/ USB-A Connector | Adafruit (https://www.adafruit.com/products/1994) | $6.95 | 0 | $0.00 |  |  |  |  | 0 | 0 | 0 | 0
5V 550mA Switch PS via USB | Digikey (http://www.digikey.com/product-detail/en/PSM03A-050Q/993-1030-ND/2384456) | $4.25 | 0 | $0.00 |  |  |  |  | 0 | 0 | 0 | 0
Bluetooth Mouse | Amazon (https://www.amazon.com/Microsoft-Sculpt-Comfort-Bluetooth-H3S-00003/dp/B00BZC31WQ?s=pc) | $24.95 | 0 | $0.00 |  |  |  |  | 0 | 0 | 0 | 0
Electric Soldering Iron | Amazon (http://smile.amazon.com/Weller-WES51-Analog-Soldering-Station/dp/B000BRC2XU) | $93.37 | 0 | $0.00 |  |  |  |  | 0 | 0 | 0 | 0
Small soldering tip | Amazon (http://smile.amazon.com/Weller-eto-0-8-PRICE-EACH/dp/B0002BSQRQ) | $6.11 | 0 | $0.00 |  |  |  |  | 0 | 0 | 0 | 0
Small soldering tip | Digikey (http://www.digikey.com/product-detail/en/ETH/ETH-ND/251751) | $4.10 | 0 | $0.00 |  |  |  |  | 0 | 0 | 0 | 0
Head magnifier | Amazon (http://smile.amazon.com/gp/product/B003UCODIA?psc=1&redirect=true&ref_=oh_aui_search_detailpage) | $8.99 | 0 | $0.00 |  |  |  |  | 0 | 0 | 0 | 0
AAA Batteries | Digikey (http://www.digikey.com/product-detail/en/LR03XWA%2FB/P645-ND/2043736) | $0.38 | 0 | $0.00 |  |  |  |  | 0 | 0 | 0 | 0
pcb vise | Amazon (http://smile.amazon.com/gp/product/B000B61D22?psc=1&redirect=true&ref_=oh_aui_search_detailpage) | $26.99 | 0 | $0.00 |  |  |  |  | 0 | 0 | 0 | 0
Total |  |  |  | $22.00 |  | $105.68 |  | $112.95 | board cost
 |  |  |  |  |  |  |  | $112.40 |  |  | $143.77
 | Amazon |  |  | $0.00 |  | $46.98 | 41.6% | $46.98 | 41.6%
 | Digikey |  |  | $22.00 |  | $22.34 | 19.8% | $29.17 | 25.8%
 | McMaster-Carr |  |  | $0.00 |  | $3.38 | 3.0% | $3.38 | 3.0%
 | Allied Electronics |  |  | $0.00 |  | $14.62 | 12.9% | $14.62 | 12.9%
 | Pololu |  |  | $0.00 |  | $8.95 | 7.9% | $0.00 | 0.0%
 | OSHPark |  |  | $0.00 |  | $9.40 | 8.3% | $18.80 | 16.6%
 | Sparkfun |  |  | $0.00 |  | $0.00 | 0.0% | $0.00 | 0.0%
Discontinued
Orange 2V 20mA 0603 LED | Digikey (http://www.digikey.com/product-detail/en/LTST-C191KFKT/160-1445-1-ND/386832) | $0.24 | 0 | $0.00 |  | 0 |  |  | 0 | 0 | 0 | 0
MCP1825S33 3V3 Voltage Regulator | Digikey (http://www.digikey.com/product-detail/en/MCP1825S-3302E%2FDB/MCP1825S-3302E%2FDB-ND/1636103) | $0.51 | 0 | $0.00 |  | 0 |  |  | 0 | 0 | 0 | 0
485 shield | Sparkfun (https://www.sparkfun.com/products/12965) | $11.95 | 0 | $0.00 |  | 0 |  |  | 0 | 0 | 0 | 0
2.1mm barrel jack | Pololu (https://www.pololu.com/product/1139) | $0.85 | 0 | $0.00 |  | 0 |  |  | 0 | 2 | 2 | 0
D24V5F5 5V, .5A power regulator | Pololu (https://www.pololu.com/product/2843) | $4.95 | 0 | $0.00 |  | 0 |  |  | 0 | 2 | 2 | 0
CR2032 Battery Holder | Sparkfun (https://www.sparkfun.com/products/783) | $1.50 | 0 | $0.00 |  | 0 |  |  | 0 | 0 | 0 | 0
Heat sink .4 x .4" | Adafruit (https://www.adafruit.com/products/1042) | $1.95 | 0 | $0.00 |  | 0 |  |  | 0 | 3 | 3 | 0
Heat Sink .25 x .25" | Adafruit (https://www.adafruit.com/products/1515) | $4.95 | 0 | $0.00 |  | 0 |  |  | 0 | 0 | 0 | 0
8GB Micro SD Card | Amazon (http://www.amazon.com/SanDisk-MicroSDHC-Standard-Packaging-SDSDQUAN-008G-G4A/dp/B00M55C0VU) | $7.62 | 0 | $0.00 |  | 0 |  |  | 0 | 3 | 3 | 0
32GB Micro SD Card | Amazon (http://www.amazon.com/SanDisk-microSDHC-Standard-Packaging-SDSQUNC-032G-GN6MA/dp/B010Q57T02?s=electronics) | $12.86 | 0 | $0.00 |  | 0 |  |  | 0 | 0 | 0 | 0
D24V5F3, .5A power regulator | Pololu (https://www.pololu.com/product/2842) | $4.95 | 0 | $0.00 |  | 0 |  |  | 0 | 0 | 0 | 0
1x8 female header | Digikey (http://www.digikey.com/product-detail/en/PPPC081LFBN-RC/S7041-ND/810180) | $0.89 | 0 | $0.00 |  | 0 |  |  | 0 | 0 | 0 | 0
100ohm 1206 resistor | Digikey (http://www.digikey.com/product-detail/en/RC1206FR-07100RL/311-100FRCT-ND/731438) | $0.10 | 0 | $0.00 |  | 0 |  |  | 0 | 0 | 0 | 0
220ohm 1206 resistor | Digikey (http://www.digikey.com/product-detail/en/RC1206FR-07220RL/311-220FRCT-ND/731640) | $0.10 | 0 | $0.00 |  | 0 |  |  | 0 | 0 | 0 | 0
Term Block 3 Pin .2" 180 plug | Digikey (http://www.digikey.com/product-detail/en/796634-3/A98224-ND/1827083) | $1.40 | 0 | $0.00 |  | 0 |  |  | 0 | 0 | 0 | 0
PCB - 3V3 - 42 x 49 mm | OSHPark (https://oshpark.com/) | $5.32 | 0 | $0.00 |  | 6 |  |  | 0 | 0 | 0 | 0
PCB -3V3 - 32.8 x 86.9 mm | OSHPark (https://oshpark.com/) | $7.35 | 0 | $0.00 |  | 0 |  |  | 0 | 0 | 0 | 0
PCB - 3V3 - 49.5 x 58.5 mm | OSHPark (https://oshpark.com/) | $7.47 | 3 | $22.42 |  | 0 |  |  | 3 | 3 | 0 | 0
Teensy 3.2 | PJRC (https://www.pjrc.com/store/teensy32.html) | $19.80 | 3 | $59.40 |  | 6 |  |  | 3 | 3 | 0 | 0 | SparkFun (https://www.sparkfun.com/products/13736) | $19.95
Teensy SD Card Adapter | PJRC (https://www.pjrc.com/store/wiz820_sd_adaptor.html) | $6.00 | 3 | $18.00 |  | 6 |  |  | 3 | 3 | 0 | 0
Wiz820io | Mouser (http://www.mouser.com/ProductDetail/WIZnet/WIZ820io/?qs=b%252bXOOdUOuvZr7ySTpTRyJw%3D%3D) | $20.79 | 3 | $62.37 |  | 6 |  |  | 3 | 3 | 0 | 0
32.768 kHz Crystal 5ppm | Digikey (http://www.digikey.com/product-search/en?keywords=300-8763-ND) | $0.60 | 3 | $1.80 |  | 6 |  |  | 3 | 3 | 0 | 0
CR2032 Battery | Digikey (http://www.digikey.com/product-detail/en/CR2032/P189-ND/31939) | $0.28 | 3 | $0.84 |  | 6 |  |  | 3 | 3 | 0 | 0
Vert CR2032 Battery Holder | Digikey (http://www.digikey.com/product-detail/en/BK-5058/BK-5058-ND/2194769) | $0.88 | 3 | $2.64 |  | 6 |  |  | 3 | 3 | 0 | 0
1x4 female header | Digikey (http://www.digikey.com/product-detail/en/PPPC041LFBN-RC/S7037-ND/810176) | $0.62 | 0 | $0.00 |  | 0 |  |  | 0 | 6 | 6 | 0
1x5 female header | Digikey (http://www.digikey.com/product-detail/en/PPPC051LFBN-RC/S7038-ND/810177) | $0.65 | 3 | $1.95 |  | 6 |  |  | 3 | 3 | 0 | 0
1x6 female header | Digikey (http://www.digikey.com/product-detail/en/PPPC061LFBN-RC/S7039-ND/810178) | $0.70 | 6 | $4.20 |  | 12 |  |  | 6 | 6 | 0 | 0
1x14 female header | Digikey (http://www.digikey.com/product-detail/en/PPPC141LFBN-RC/S7047-ND/810186) | $0.98 | 12 | $11.76 |  | 24 |  |  | 12 | 12 | 0 | 0
1x40 male header | Digikey (http://www.digikey.com/product-detail/en/PRPC040SAAN-RC/S1011EC-40-ND/2775214) | $0.74 | 0 | $0.00 |  | 1 |  |  | 0 | 21.875 | 21.875 | 0
1x40 male dbl long header | Digikey (http://www.digikey.com/product-search/en?vendor=0&keywords=PRPC040SACN-RC) | $0.99 | 1 | $0.99 |  | 5 |  |  | 1 | 3.175 | 2.175 | 0 |  | 64
120ohm 1206 resistor | Digikey (http://www.digikey.com/product-detail/en/RC1206FR-07120RL/311-120FRCT-ND/731470) | $0.10 | 0 | $0.00 |  | 0 |  |  | 0 | 0 | 0 | 0
270ohm 1206 resistor | Digikey (http://www.digikey.com/product-detail/en/RC1206FR-07270RL/311-270FRCT-ND/731681) | $0.10 | 0 | $0.00 |  | 0 |  |  | 0 | 0 | 0 | 0 | 10
510ohm 1206 resistor | Digikey (http://www.digikey.com/product-detail/en/RC1206JR-07510RL/311-510ERCT-ND/732257) | $0.10 | 0 | $0.00 |  | 0 |  |  | 0 | 0 | 0 | 0 | 10
680ohm 1206 resistor | Digikey (http://www.digikey.com/product-detail/en/RC1206FR-07680RL/311-680FRCT-ND/732011) | $0.10 | 0 | $0.00 |  | 0 |  |  | 0 | 0 | 0 | 0 | 10
1kohm 1206 resistor | Digikey (http://www.digikey.com/product-detail/en/RC1206FR-071KL/311-1.00KFRCT-ND/731334) | $0.10 | 0 | $0.00 |  | 0 |  |  | 0 | 0 | 0 | 0 | 10
10kohm 1206 resistor | Digikey (http://www.digikey.com/product-detail/en/RC1206JR-0710KL/311-10KERCT-ND/732156) | $0.10 | 0 | $0.00 |  | 0 |  |  | 0 | 0 | 0 | 0 | 10
104 1206 capacitor | Digikey (http://www.digikey.com/product-detail/en/C1206C104J5RACTU/399-1250-1-ND/411525) | $0.10 | 0 | $0.00 |  | 0 |  |  | 0 | 0 | 0 | 0
Green 2V 20mA 1206 LED | Digikey (http://www.digikey.com/product-detail/en/LTST-C230KGKT/160-1456-1-ND/386854) | $0.30 | 0 | $0.00 |  | 0 |  |  | 0 | 0 | 0 | 0
Red 2V 20mA 1206 LED | Digikey (http://www.digikey.com/product-detail/en/LTST-C230KRKT/160-1457-1-ND/386856) | $0.30 | 0 | $0.00 |  | 0 |  |  | 0 | 0 | 0 | 0
Orange 2V 20mA 1206 LED | Digikey (http://www.digikey.com/product-detail/en/LTST-C230KFKT/160-2025-1-ND/3711400) | $0.29 | 0 | $0.00 |  | 0 |  |  | 0 | 0 | 0 | 0
Term Block 6Pin .2" 180 header | Digikey (http://www.digikey.com/product-detail/en/1546111-6/A112348-ND/2221132) | $2.42 | 0 | $0.00 |  | 0 |  |  | 0 | 0 | 0 | 0
Term Block 3 Pin .2" 270 Plug | Digikey (http://www.digikey.com/product-detail/en/284041-3/A98129-ND/1826991) | $2.73 | 6 | $16.38 |  | 12 |  |  | 6 | 6 | 0 | 0
R-78-E5.0, 500mA voltage regulator | Digikey (http://www.digikey.com/product-detail/en/recom-power/R-78E5.0-0.5/945-1648-5-ND/2834904) | $2.84 | 3 | $8.52 |  | 6 |  |  | 3 | 3 | 0 | 0
Wide DIN case | Digikey (http://www.digikey.com/product-detail/en/DMB-4771/377-1808-ND/2499327) | $5.50 | 3 | $16.50 |  | 6 |  |  | 3 | 3 | 0 | 0
Wide DIN case clear cover | Digikey (http://www.digikey.com/product-search/en?vendor=0&keywords=dmb-4771-cc) | $1.10 | 3 | $3.30 |  | 6 |  |  | 3 | 3 | 0 | 0
Slim DIN case | Digikey (http://www.digikey.com/product-detail/en/DMB-4770/377-1807-ND/2499326) | $4.50 | 0 | $0.00 |  | 0 |  |  | 0 | 0 | 0 | 0
Heatsink 10mm square | Digikey (http://www.digikey.com/product-detail/en/assmann-wsw-components/V2017B/AE10837-ND/3511410) | $0.75 | 6 | $4.50 |  | 6 |  |  | 6 | 6 | 0 | 0
MB85RS256BPNF FRAM 32kB Memory | Digikey (http://www.digikey.com/product-detail/en/fujitsu-electronics-america-inc/MB85RS256BPNF-G-JNERE1/865-1251-1-ND/4022686) | $3.50 | 3 | $10.50 |  | 0 |  |  | 3 | 3 | 0 | 0
NC7SB3157P6X SPDT | Digikey (http://www.digikey.com/product-detail/en/fairchild-semiconductor/NC7SB3157P6X/NC7SB3157P6XCT-ND/1305384) | $0.39 | 3 | $1.17 | 0 | 0 | 0 | 0 | 3 | 3 | 0 | 0
SPDT dip switch | Digikey (http://www.digikey.com/product-detail/en/CJS-1200TB/563-1022-1-ND/948402) | $0.86 | 0 | $0.00 | 0 | 0 | 0 | 0 | 0 | 0 | 0 | 0
273 0603 capacitor | Digikey (http://www.digikey.com/product-detail/en/samsung-electro-mechanics-america-inc/CL10B273KB8NNNC/1276-2025-1-ND/3890111) | $0.11 | 0 | $0.00 | 0 | 0 | 0 | 0 | 0 | 0 | 0 | 0
5.1kohm 0603 resistor | Digikey (http://www.digikey.com/product-detail/en/yageo/RC0603FR-075K1L/311-5.10KHRCT-ND/730215) | $0.01 | 0 | $0.00 | 0 | 0 | 0 | 0 | 0 | 0 | 0 | 0
Max485esa+ transceiver 5V | Digikey (http://www.digikey.com/product-detail/en/MAX485ESA%2B/MAX485ESA%2B-ND/1495323) | $2.66 | 0 | $0.00 | 0 | 0 | 0 | 0 | 3 | 3 | 0 | 0

Sheet: beth_compile
 |  | Approx. |  | Approx.
Part | Link | Cost Per | # to Order | Order Cost
DIN Rail enclosure | Allied Electronics (https://www.alliedelec.com/hitaltech-usa-25-041all01-rmb/70420316/) | $14.62 | 6 | $87.72 | Subtotal | $87.72
Raspberry Pi 3 Model B | Amazon (https://www.amazon.com/Raspberry-Model-1-2GHz-64-bit-quad-core/dp/B01CD5VC92?s=pc) | $36.99 | 6 | $221.94
16GB Micro SD Card | Amazon (https://www.amazon.com/SanDisk-Ultra-Micro-Adapter-SDSQUNC-016G-GN6MA/dp/B010Q57SEE) | $9.99 | 6 | $59.94 | Subtotal | $281.88
R-78E5.0-1.0 5V 1A DC DC Converter | Digikey (https://www.digikey.com/product-detail/en/recom-power/R-78E5.0-1.0/945-2201-ND/4930585) | $3.26 | 6 | $19.56
510ohm 1% 0603 resistor | Digikey (http://www.digikey.com/product-detail/en/RC0603FR-07510RL/311-510HRCT-ND/730232) | $0.01 | 10 | $0.15
1kohm 1% 0603 resistor | Digikey (http://www.digikey.com/product-detail/en/RC0603FR-071KL/311-1.00KHRCT-ND/729790) | $0.01 | 10 | $0.15
10kohm 1% 0603 resistor | Digikey (http://www.digikey.com/product-detail/en/RC0603FR-0710KL/311-10.0KHRCT-ND/729827) | $0.01 | 10 | $0.15
2x20 female header | Digikey (https://www.digikey.com/product-detail/en/sullins-connector-solutions/PPTC202LFBN-RC/S6104-ND/807240) | $2.29 | 3 | $6.87
Term Block 3 Pin .2" 90 female header | Digikey (https://www.digikey.com/product-detail/en/phoenix-contact/1786417/277-5985-ND/349072) | $3.08 | 10 | $30.80
Term Block 3 Pin .2" 180 male plug | Digikey (https://www.digikey.com/product-detail/en/phoenix-contact/1786187/277-5720-ND/349067) | $4.28 | 10 | $42.80
MAX3485CSA Transceiver 3V | Digikey (https://www.digikey.com/product-detail/en/maxim-integrated/MAX3485CSA-T/MAX3485CSA-CT-ND/5405739) | $4.57 | 6 | $27.42
2N7002 transistor sot-23-3 | Digikey (http://www.digikey.com/product-detail/en/2N7002LT1G/2N7002LT1GOSCT-ND/917791) | $0.16 | 10 | $1.60
SPDT dip switch neutral setting | Digikey (http://www.digikey.com/product-detail/en/CJS-1201TB/563-1024-1-ND/948406) | $1.11 | 10 | $11.10
DPDT dip switch | Digikey (http://www.digikey.com/product-detail/en/CAS-220TB/CAS220GCT-ND/341727) | $1.96 | 10 | $19.60 | Subtotal | $160.20
#4-40 7/16" standoff | McMaster-Carr (https://www.mcmaster.com/) | $0.68 | 24 | $16.32 | Subtotal | $16.32
485/Power PiHat 2.0 Super Swift | OSHPark (https://oshpark.com/) | $18.80 | 6 | $112.80 | Subtotal | $112.80
 |  |  | Total | $658.92

Sheet: sd_card_size
datetime chars | 18
num meters | 20 |  |  |  |  |  |  |  | 1.036781609 |  | 18 | 17.36141907
num vals per mtr | 32 |  |  |  |  |  |  |  | 1.066666667 |  |  | 16.875
num vals tot | 640 |  |  |  |  |  |  |  | 14.5 | 15.03333333
chars per val | 11 |  |  |  |  |  |  |  |  | 15.46666667
commas + newline | 642 |  |  |  |  | 30.51757812
 |  |  |  |  |  | 0.0006103515625
chars per line | 7700 | bytes |  |  |  | 2e-05
hdr chars | 1022 |  |  |  |  | 2e-05
 |  |  |  |  |  | 31536000
 |  |  |  |  |  | 31.536 | s/mB
poll x mins | 5 | mins/poll |  |  | 20 yrs | 630.72 | 10.512 | mins/Mb
years storage | 5 | yrs |  |  |  | 157.68 | 2.628
 | needed space | 4.049 | Gb
poll x mins | 5 | mins/poll
total space | 8 | Gb
 | years storage | 9.884 | yrs
years storage | 10 | yrs
total space | 8 | Gb
 | poll x mins | 5.06 | mins/poll
 |  |  |  | 10.66666667

Sheet: logo
 |  | 0.5 | 0.3 | 0.5833333333 |  | radius | 0.0375 | 0.022
 | internal polygons |  |  |  |  | external curves
 | x | y |  | x | y | x | y |  | x | y | x | y
 | 0.01 | -0.147 |  | 0.010 | -0.082 | -0.01 | -0.25 |  | -0.002 | -0.142 | -0.01 | -0.142
 | 0.01 | -0.25 |  | 0.010 | -0.142 | 0.25 | -0.556 |  | 0.150 | -0.320 | 0.15 | -0.327
left tri | 0.017 | -0.3 |  | 0.014 | -0.171 | 0.51 | -0.456 |  | 0.302 | -0.262 | 0.31 | -0.142
 | 0.029 | -0.342 |  | 0.021 | -0.195
 | 0.25 | -0.147 |  | 0.150 | -0.082
 | 0.25 | -0.147 |  | 0.150 | -0.082
right tri | 0.471 | -0.342 |  | 0.279 | -0.195
 | 0.483 | -0.3 |  | 0.286 | -0.171
 | 0.49 | -0.25 |  | 0.290 | -0.142
 | 0.49 | -0.147 |  | 0.290 | -0.082 |  |  | 0.2362 | 0.25 |  |  |  |  | 0.004
 |  |  |  |  |  | top |  | right |  | bot |  | left |  | top |  | right |  | bot |  | left
 | 0.125 | -0.343 |  | 0.077 | -0.196 | 0.125 | -0.3005 | 0.1675 | -0.343 | 0.125 | -0.3855 | 0.0825 | -0.343 | 0.077 | -0.170 | 0.103 | -0.196 | 0.077 | -0.222 | 0.051 | -0.196
circles | 0.375 | -0.343 |  | 0.223 | -0.196 | 0.375 | -0.3005 | 0.4175 | -0.343 | 0.375 | -0.3855 | 0.3325 | -0.343 | 0.223 | -0.170 | 0.249 | -0.196 | 0.223 | -0.222 | 0.197 | -0.196
 | 0.25 | -0.245 |  | 0.150 | -0.139 | 0.25 | -0.2025 | 0.2925 | -0.245 | 0.25 | -0.2875 | 0.2075 | -0.245 | 0.150 | -0.113 | 0.176 | -0.139 | 0.150 | -0.165 | 0.124 | -0.139
 | 0.104 | -0.456 |  | 0.065 | -0.262
bot poly | 0.15 | -0.492 |  | 0.092 | -0.283
 | 0.2 | -0.518 |  | 0.121 | -0.298
 | 0.25 | -0.534 |  | 0.150 | -0.307
 | 0.3 | -0.518 |  | 0.179 | -0.298
 | 0.35 | -0.492 |  | 0.208 | -0.283
 | 0.396 | -0.456 |  | 0.235 | -0.262
 | 0.25 | -0.317 |  | 0.150 | -0.181

Sheet: Web Sheets
Digi-Key Electronics - Electronic Components Distributor
United States 1-800-344-4539
Change Country USEnglish USD
Your item(s)
View Cart
Login or
REGISTER
LoginRegister
PRODUCTS MANUFACTURERS
RESOURCES
Research
Academic Program
Articles
Content Library
Newest Products
Product Training Modules
Video Library
Design
Conversion Calculators
EDA & Design Tools
Reference Designs
TechZones℠
Search / Ordering
BOM Manager
Browser Resources
Online Catalog
Order Status
Shopping Cart
LIVE CHAT
Product Index > Connectors, Interconnects > Rectangular Connectors - Headers, Male Pins > Sullins Connector Solutions PRPC040SACN-RC
Share
Share this on:
Or copy the link below:
This feature is temporarily unavailable. We are working diligently to get this fixed. Thank you for your patience.
Add To Favorites
This feature is only available for registered users. Please Login or Register.
PRPC040SACN-RC Sullins Connector Solutions | S1131EC-40-ND DigiKey Electronics
Product Overview
Digi-Key Part Number | S1131EC-40-ND
Quantity Available | 1877
 | Can ship immediately
Manufacturer | Sullins Connector Solutions
Manufacturer Part Number | PRPC040SACN-RC
Description | 40 Positions Header, Unshrouded, Breakaway Connector 0.100" (2.54mm) Through Hole Gold
Lead Free Status / RoHS Status | Lead free / RoHS Compliant
Moisture Sensitivity Level (MSL) | 1 (Unlimited)
Manufacturer Standard Lead Time | 3 Weeks
Documents & Media
Datasheets | zzzCzzzSzzN-RC Drawing
Featured Product | .100" Brass Header
PCN Design/Specification | PBT Reflow Process/Not Recommended 05/Apr/2012
Online Catalog | 0.100" (2.54mm) Pitch Connector Headers
Product Attributes | Select All
Category | Connectors, Interconnects
Family | Rectangular Connectors - Headers, Male Pins
Manufacturer | Sullins Connector Solutions
Series | -
Packaging ? | Bulk ?
Part Status | Active
Contact Type | Male Pin
Connector Type | Header, Unshrouded, Breakaway
Number of Positions | 40
Number of Positions Loaded | All
Pitch | 0.100" (2.54mm)
Number of Rows | 1
Row Spacing | -
Contact Mating Length | 0.230" (5.84mm)
Mounting Type | Through Hole
Termination | Solder
Fastening Type | -
Features | -
Contact Finish | Gold
Contact Finish Thickness | Flash
Color | Black
Report an Error
You May Also Be Interested In:
PRPC040SAAN-RC - Sullins Connector Solutions | S1011EC-40-ND DigiKey Electronics
PRPC040SAAN-RC
Sullins Connector Solutions
CONN HEADER .100" SNGL STR 40POS
Unit Price 0.74000
PRPC040SFAN-RC - Sullins Connector Solutions | S1211EC-40-ND DigiKey Electronics
PRPC040SFAN-RC
Sullins Connector Solutions
CONN HEADER .100" SNGL STR 40POS
Unit Price 0.84000
PRPC040DAAN-RC - Sullins Connector Solutions | S2011EC-40-ND DigiKey Electronics
PRPC040DAAN-RC
Sullins Connector Solutions
CONN HEADER .100" DUAL STR 80POS
Unit Price 1.47000
85 - Adafruit Industries LLC | 1528-1074-ND DigiKey Electronics
85
Adafruit Industries LLC
STACKING HEADER ARDUINO SHIELD
Unit Price 1.95000
PPPC061LFBN-RC - Sullins Connector Solutions | S7039-ND DigiKey Electronics
PPPC061LFBN-RC
Sullins Connector Solutions
CONN HEADER FEMALE 6POS .1" GOLD
Unit Price 0.70000
Additional Resources
Standard Package ? | 1
Other Names | PRPC040SACNRC
 | S9528E-40
 | S9528E-40-ND
2016-08-26 12:42
Price & Procurement
Quantity
All prices are in US dollars.
Price Break | Unit Price | Extended Price
1 | 0.99 | 0.99
10 | 0.89 | 8.9
100 | 0.7329 | 73.29
500 | 0.57934 | 289.67
1000 | 0.49733 | 497.33
5000 | 0.4537 | 2268.50
10000 | 0.43625 | 4362.50
Submit a request for quotation on quantities greater than those displayed.
Alternate Length
Digi-Key Part Number: S1131EC-04-ND
Description: CONN HEADER .100" SNGL STR 4POS
Quantity Available: 930 - Immediate
Value Added Item ?
Digi-Key Part Number: S1131EC-01-ND
Description: CONN HEADER .100" SNGL STR 1POS
Quantity Available: Value Added Item ?
Digi-Key Part Number: S1131EC-02-ND
Description: CONN HEADER .100" SNGL STR 2POS
Quantity Available: Value Added Item ?
Digi-Key Part Number: S1131EC-03-ND
Description: CONN HEADER .100" SNGL STR 3POS
Quantity Available: Value Added Item ?
Digi-Key Part Number: S1131EC-05-ND
Description: CONN HEADER .100" SNGL STR 5POS
Quantity Available: Value Added Item ?
View More
Send Feedback
Information | Digi-Key Mobile AppsFacebookGoogle PlusLinkedInTwitterYoutube
 | Copyright © 1995-2016, Digi-Key Electronics.
Terms & Conditions | All Rights Reserved.
About Digi-Key | 701 Brooks Avenue South,
Contact Us | Thief River Falls, MN 56701 USA
Newsroom
Site Map | ECIA/CEDA/ECSN Member
Supported Browsers
Privacy Statement
Careers
United States
sales@digikey.com
Toll Free: 1-800-344-4539
Phone: 218-681-6674
Fax: 218-681-3380
Live Chat
International
Africa
Asia
Australia
Europe
Middle East
North America
South America
