mteter-upenn/PCB_PiGateway/pihat_rs485_pwr.brd

## EAGLE design pihat_rs485_pwr.brd (2018-02-01)

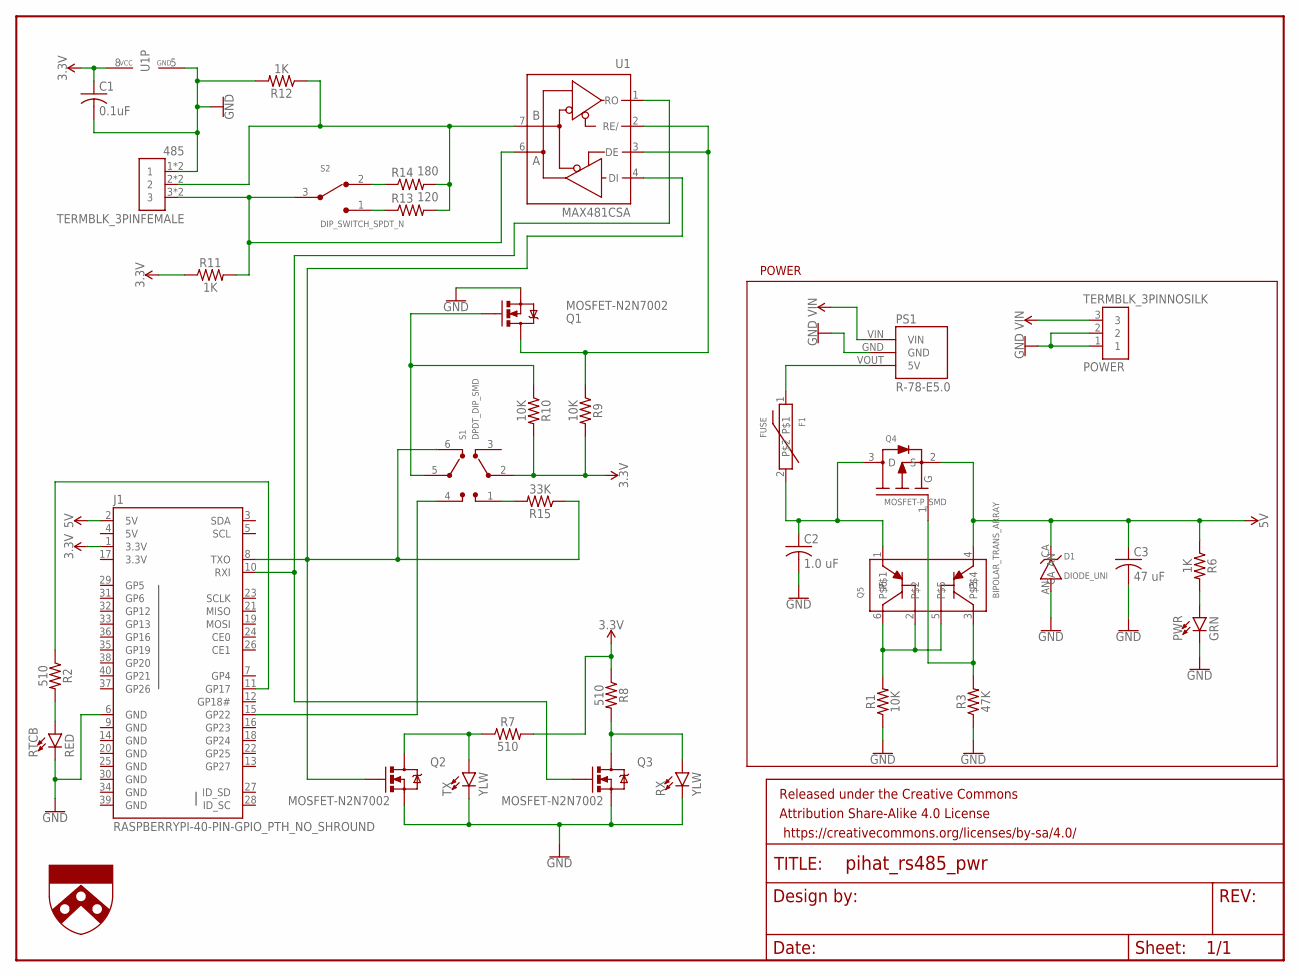
[picture p1: schematic pihat_rs485_pwr.sch]

Parts:
485: TERMBLK_3PINFEMALE; TERMBLK_FEMALE_3PIN_90_NOSILK
C1: 0.1uF; C0603
C2: 1.0 uF; C0603
C3: 47 uF; C0603
D1: DIODE_UNI; DO-214AA_UNI
F1: FUSE; 1812_STD_BI
FRAME1: FRAME-LETTERNO_PACKAGE; DUMMY
J1: RASPBERRYPI-40-PIN-GPIO_PTH_NO_SHROUND; PI_2X20
POWER: TERMBLK_3PINNOSILK; TERMBLK_3PIN_90_NOSILK
PS1: R-78-E5.0; R-78-EXX
PWR: GRN; LED-0603
Q1, Q2, Q3: MOSFET-N2N7002; SOT23-3
Q4: MOSFET-P_SMD; SOT23-3
Q5: BIPOLAR_TRANS_ARRAY; SOT363
R1, R9, R10: 10K; 0603
R2, R7, R8: 510; 0603
R3: 47K; 0603
R6, R11, R12: 1K; 0603
R13: 120; 0603
R14: 180; 0603
R15: 33K; 0603
RTCB: RED; LED-0603
RX: YLW; LED-0603
S1: DPDT_DIP_SMD
S2: DIP_SWITCH_SPDT_N; SINGLE_DIP_SW_NEUT
TX: YLW; LED-0603
U1: MAX481CSA; SO08
U$4: UPENN_SHIELD_.3_SILK; UPENN_SHIELD_3_SILK

Connections:
3.3V: C1.1, J1.1 (3.3V), J1.17 (3.3V), R7.2, R8.1, R9.2, R10.2, R11.1, S1.2 (<2), U1.8 (VCC)
5V: C3.1, D1.CA, J1.2 (5V), J1.4 (5V), Q4.2 (S), Q5.4, R6.1
GND: 485.1, 485.4 (1), C1.2, C2.2, C3.2, D1.AN, J1.6 (GND), J1.9 (GND), J1.14 (GND), J1.20 (GND), J1.25 (GND), J1.30 (GND), J1.34 (GND), J1.39 (GND), POWER.1, POWER.2, PS1.GND, PWR.C, Q1.2 (S), Q2.2 (S), Q3.2 (S), R1.1, R3.1, R12.2, RTCB.C, RX.C, TX.C, U1.5 (GND)
unnamed: R14.1, S2.2
unnamed: J1.15 (GP22), S1.4 (4>)
unnamed: J1.8 (TXO), Q2.1 (G), R15.1, S1.6 (6>), U1.4 (DI)
unnamed: Q5.2, Q5.5, Q5.6, R1.2
unnamed: Q4.1 (G), Q5.3, R3.2
unnamed: C2.1, F1.2, Q4.3 (D), Q5.1
unnamed: F1.1, PS1.VOUT (5V)
unnamed: R13.1, S2.1
unnamed: 485.2, 485.5 (2), R12.1, R13.2, R14.2, U1.7 (B)
unnamed: PWR.A, R6.2
unnamed: R15.2, S1.1 (<1)
unnamed: J1.10 (RXI), Q3.1 (G), U1.1 (RO)
unnamed: R2.2, RTCB.A
unnamed: J1.11 (GP17), R2.1
unnamed: 485.3, 485.6 (3), R11.2, S2.3, U1.6 (A)
unnamed: Q1.1 (G), R10.1, S1.5 (5>)
unnamed: Q1.3 (D), R9.1, U1.2 (RE/), U1.3 (DE)
unnamed: Q3.3 (D), R8.2, RX.A
unnamed: Q2.3 (D), R7.1, TX.A
VIN: POWER.3, PS1.VIN

Notes on the sheet:
POWER

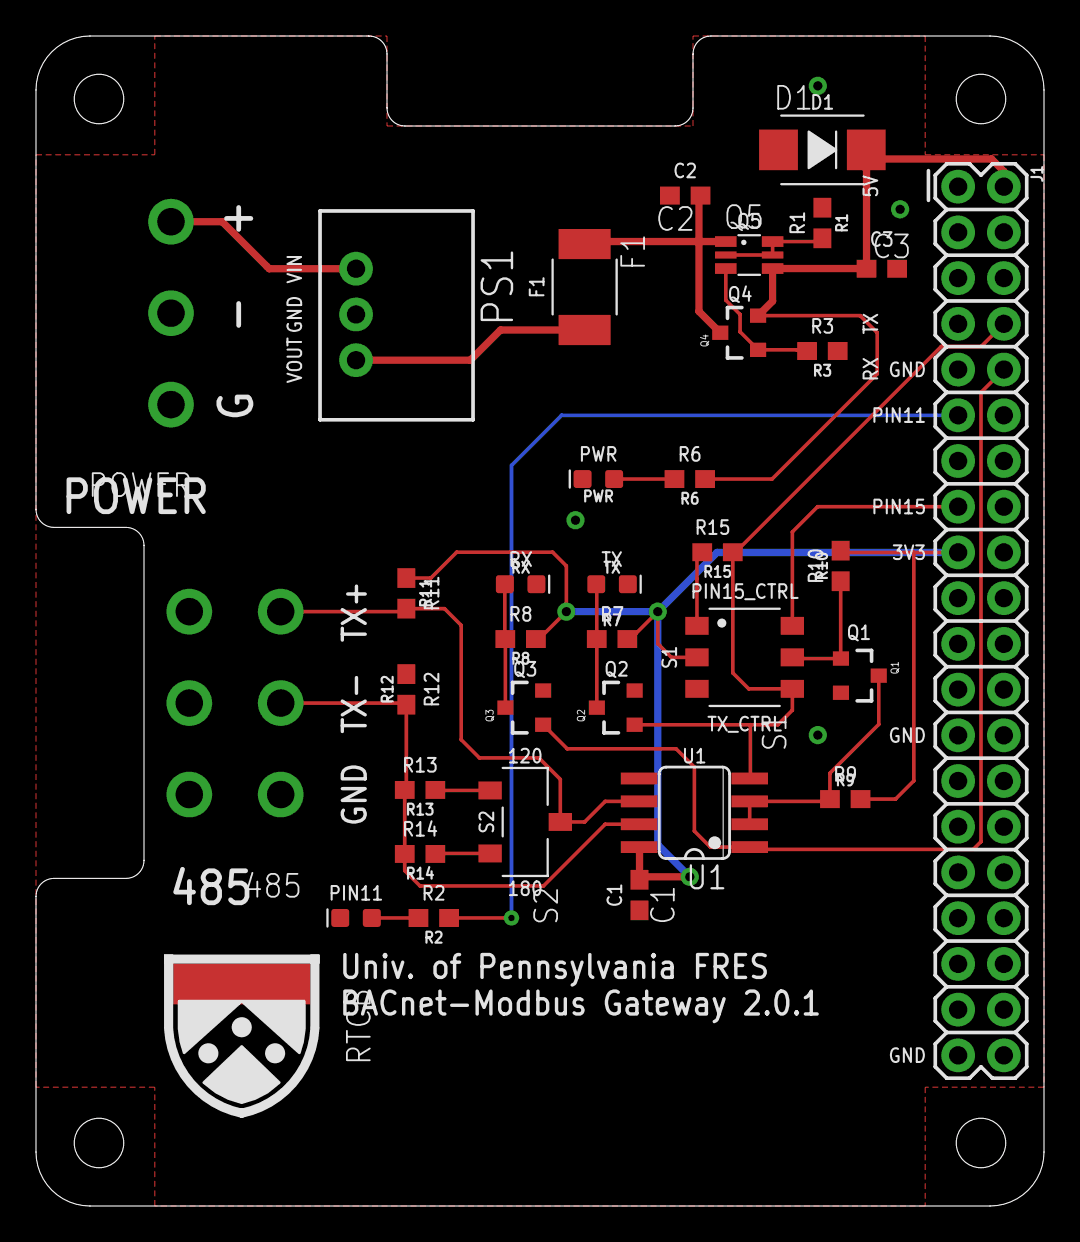
[picture p2: board pihat_rs485_pwr.brd from above]

Board: 2 copper layers, 56.0 x 65.0 mm, 36 parts (0 on the bottom side), 23 nets.
