mteter-upenn/PCB_PiGateway/(commit log)

2017-10-09 10/9/17, first commit with files
    [Modbus_shield_purchase_list.xlsx, pihat_rs485_pwr.brd, pihat_rs485_pwr.sch]
2017-10-09 10/9/17, removed teensy, changed board dims
    [pihat_rs485_pwr.brd, pihat_rs485_pwr.sch]
2017-10-16 10/16/17, mostly set
    [pihat_rs485_pwr.brd, pihat_rs485_pwr.sch]
2017-10-16 10/16/17, all silkscreens placed
    [pihat_rs485_pwr.brd, pihat_rs485_pwr.sch]
2017-10-16 10/16/17, made gerber files
    [pihat_rs485_pwr.drills.xln]
2017-10-16 10/16/17, adjusted r14 to 180ohms
    [pihat_rs485_pwr.brd, pihat_rs485_pwr.sch]
2017-11-29 11/29/17, added text file to delineate board designs
2017-11-29 11/29/17, changed PS, term blocks
    [pihat_rs485_pwr.brd, pihat_rs485_pwr.sch]
2017-11-30 11/30/17, changes to silkscreen
    [pihat_rs485_pwr.brd]
2017-11-30 11/30/17, moved some parts, updated gerbers
    [pihat_rs485_pwr.brd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]
2018-01-04 1/4/18, moved D1 and C3, updated gerbers
    [pihat_rs485_pwr.brd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]
2018-01-08 1/8/18, change R2 value from 680 to 510 to reduce parts
    [pihat_rs485_pwr.brd, pihat_rs485_pwr.sch]
2018-01-08 1/8/18, updated purchase list
    [Modbus_shield_purchase_list.xlsx]
2018-02-01 2/1/18, minor silkscreen changes
    [pihat_rs485_pwr.brd, pihat_rs485_pwr.sch]
2018-02-01 2/1/18, update gerbers
2018-02-01 2/1/18, update purchase list stocks
    [Modbus_shield_purchase_list.xlsx]
